tatomarinelli/esp-midi-phere/gui/docs/README.md

# Documentación

| Documento | De qué trata |
|---|---|
| `sysex.md` | Cómo hablan la GUI y el ESP: trama, comandos, ACK, config |
| `bootloader.md` | Entrar al modo descarga por software, flashear y volver |
| `remote-script.md` | Cómo funciona el Remote Script de Ableton y cómo instalarlo |

El estado general del proyecto, las decisiones y lo pendiente están en `../STATUS.md`.
