tatomarinelli/esp-midi-phere/enclosure/test-prints/test_holes.stl

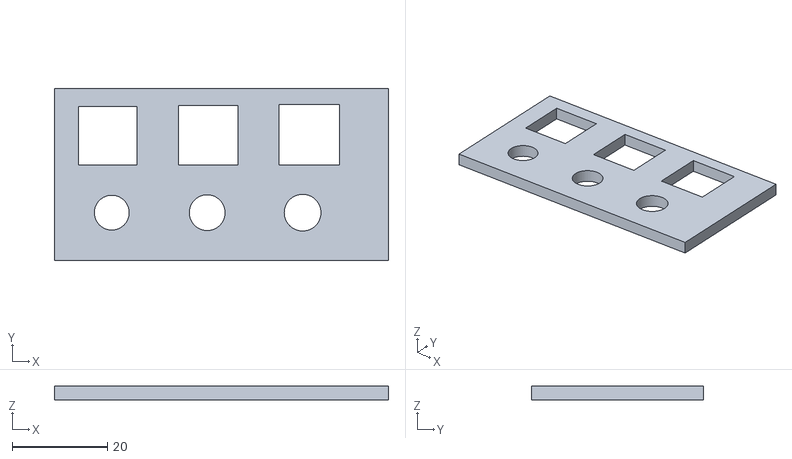
[picture p1: CAD file, 2026-10-25]
enclosure/test-prints/test_holes.stl
70.0 x 36.0 x 3.00
