tatomarinelli/esp-midi-phere/gui/assets/models/panel_print.stl

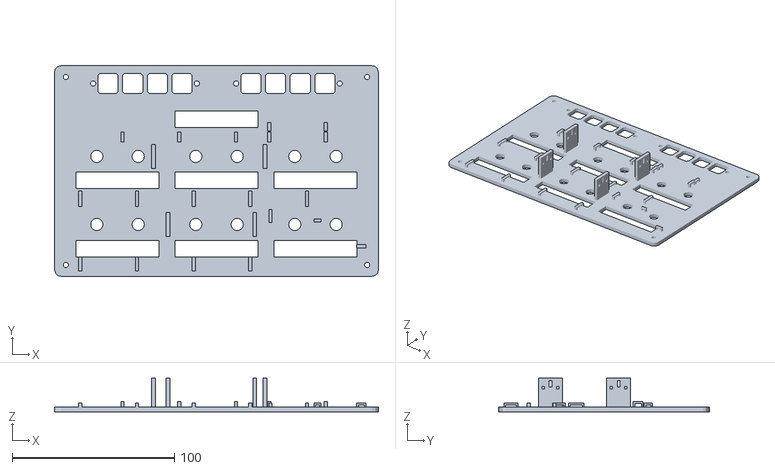
[picture p2: CAD file, 2026-10-25]
gui/assets/models/panel_print.stl
200.0 x 130.0 x 20.9
