tatomarinelli/esp-midi-phere/enclosure/test-prints/test_socket.stl

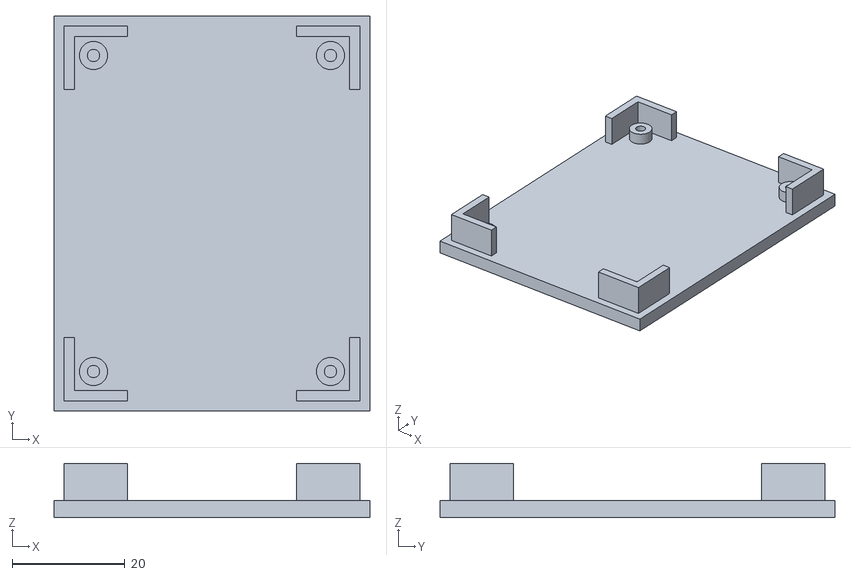
[picture p3: CAD file, 2026-10-25]
enclosure/test-prints/test_socket.stl
56.0 x 70.0 x 9.59
