tatomarinelli/esp-midi-phere/gui/assets/models/shell.stl

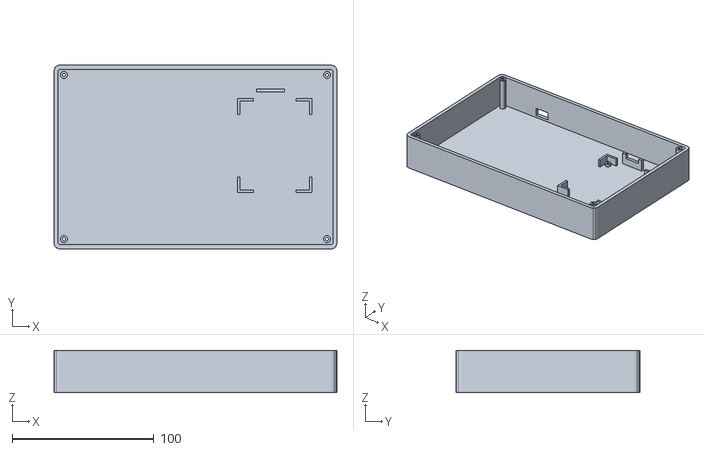
[picture p4: CAD file, 2026-10-25]
gui/assets/models/shell.stl
200.0 x 130.0 x 30.0
