tatomarinelli/esp-midi-phere/enclosure/test-prints/test_usbcut.stl

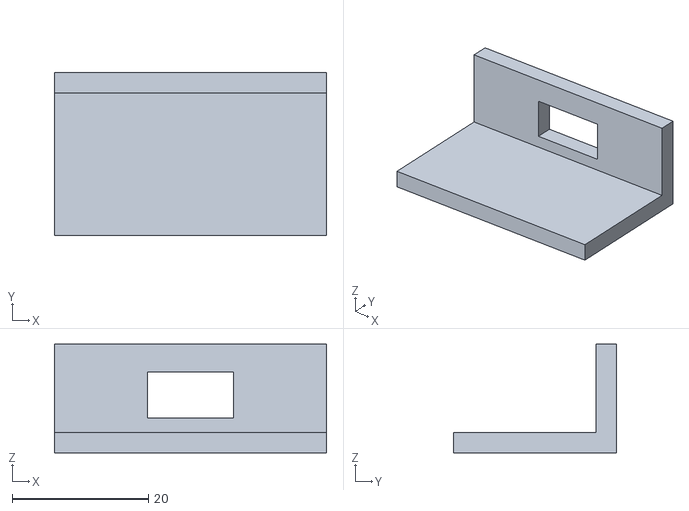
[picture p5: CAD file, 2026-10-25]
enclosure/test-prints/test_usbcut.stl
40.0 x 24.0 x 16.0
