tatomarinelli/esp-midi-phere/enclosure/test-prints/test_lid.stl

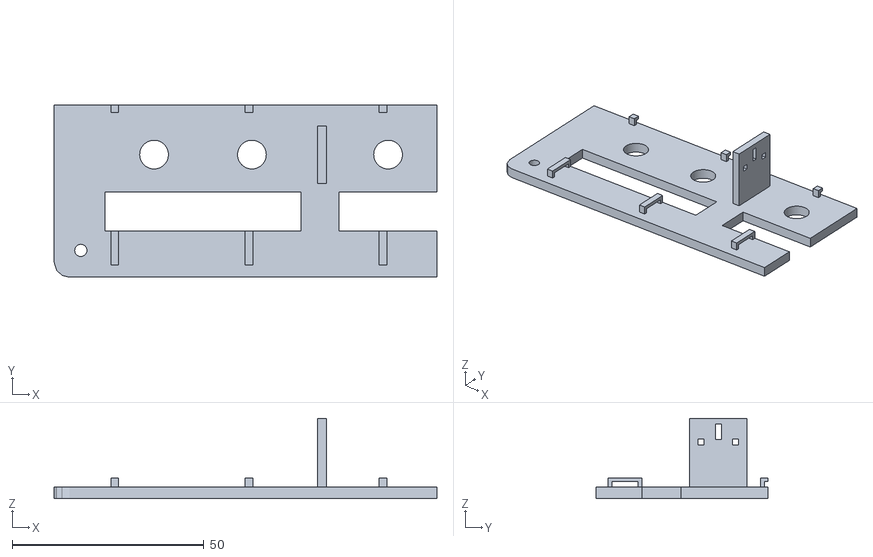
[picture p6: CAD file, 2026-10-25]
enclosure/test-prints/test_lid.stl
100.0 x 45.0 x 20.9
