tatomarinelli/esp-midi-phere/enclosure/esp-midi-phere-top-template-v7.pdf

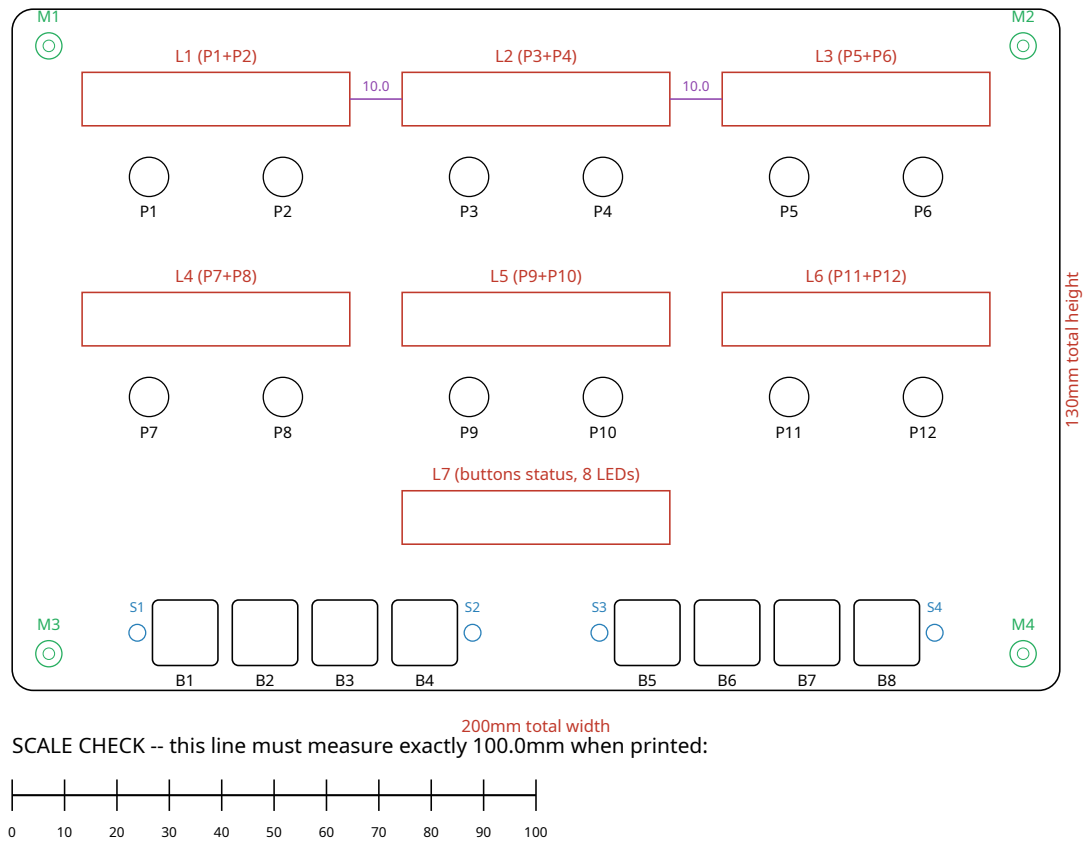
[picture p7: page 1]

SCALE CHECK -- this line must measure exactly 100.0mm when printed:
