tatomarinelli/esp-midi-phere/hardware/esp-midi-phere.kicad_sch

## KiCad design hardware/esp-midi-phere.kicad_sch (2026-10-23)

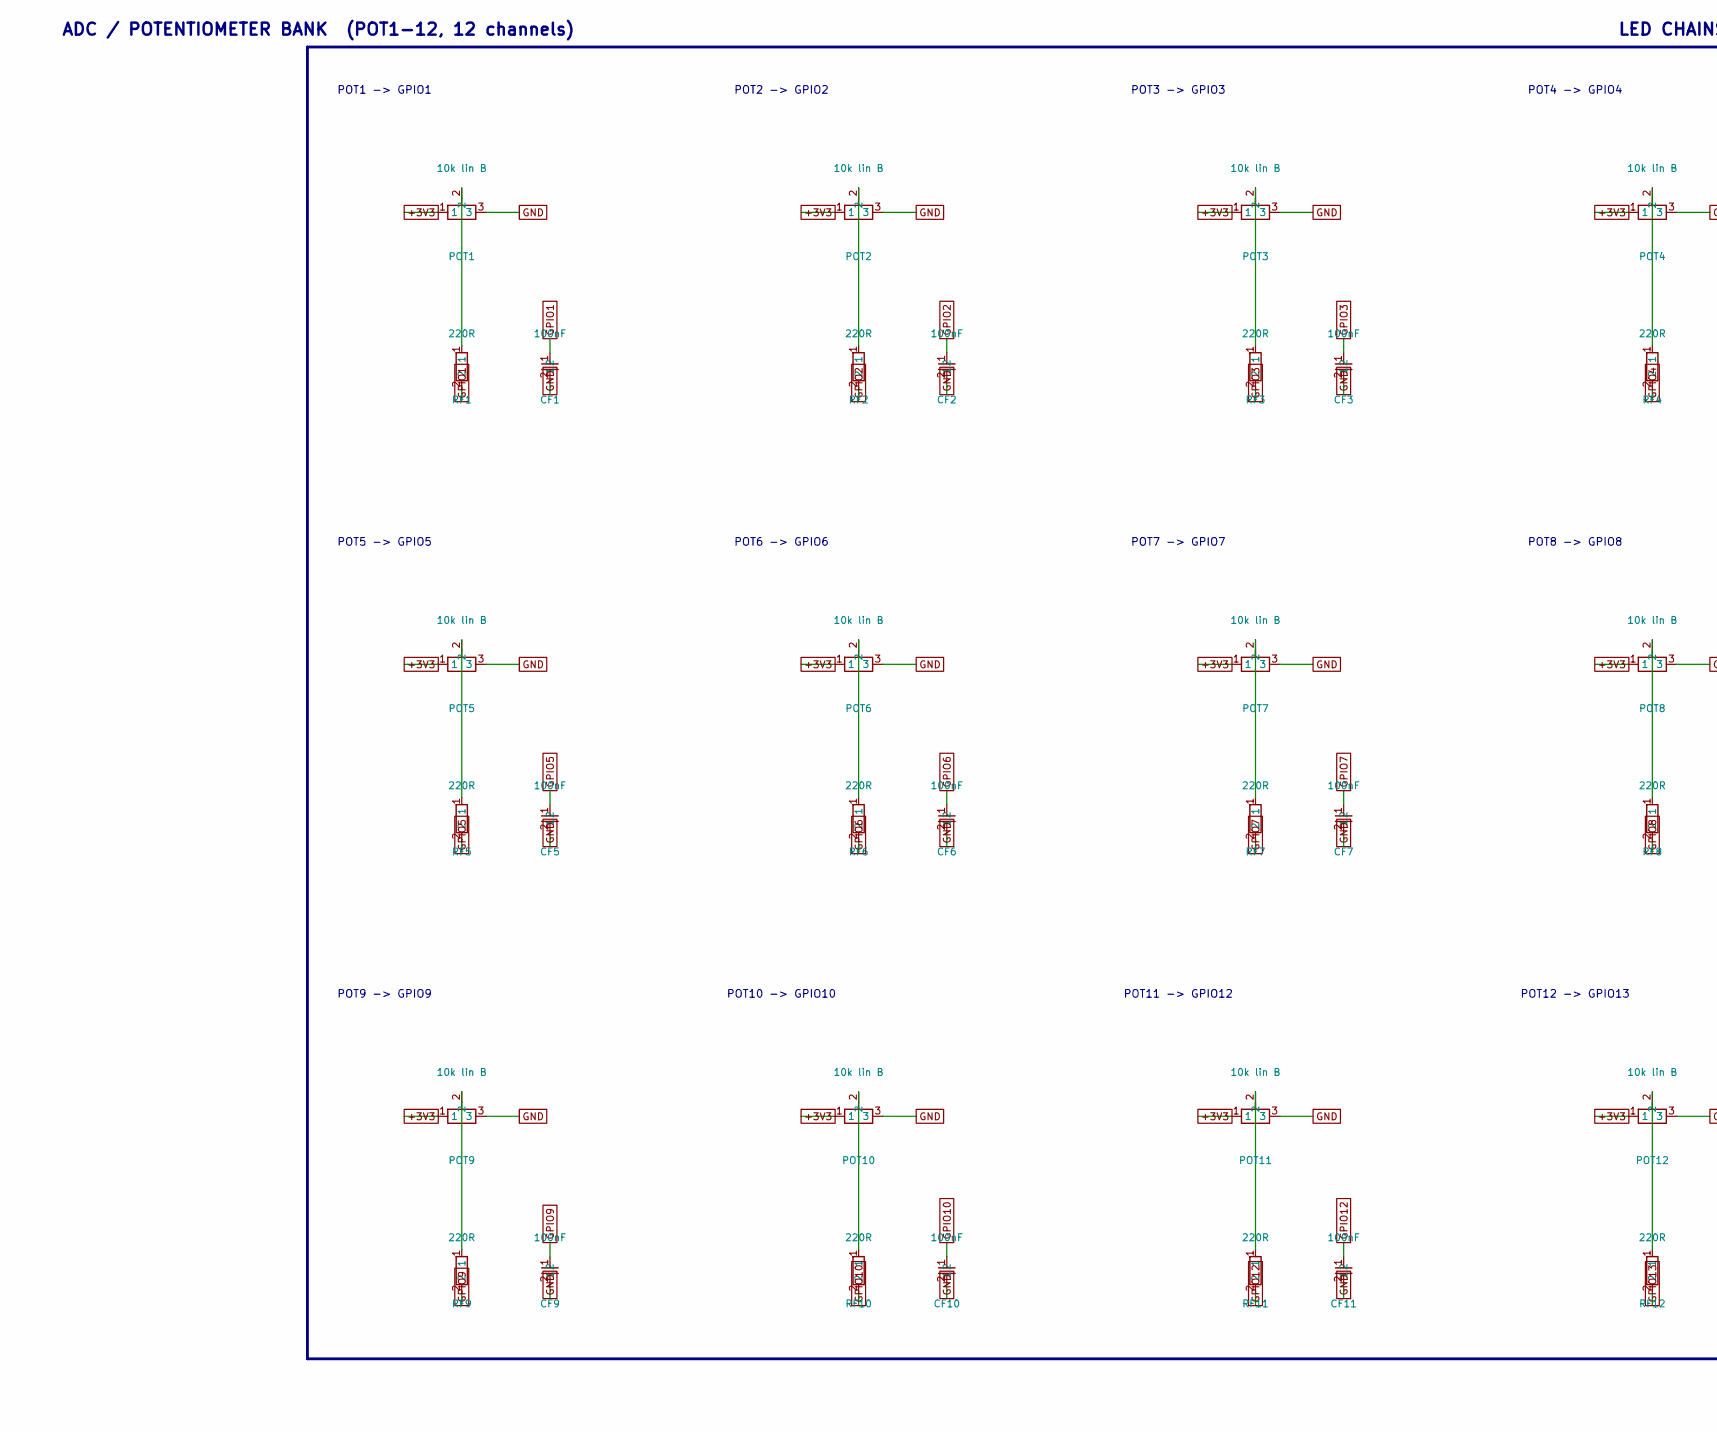
[picture p8: schematic esp-midi-phere.kicad_sch, part in row 1, column 1]

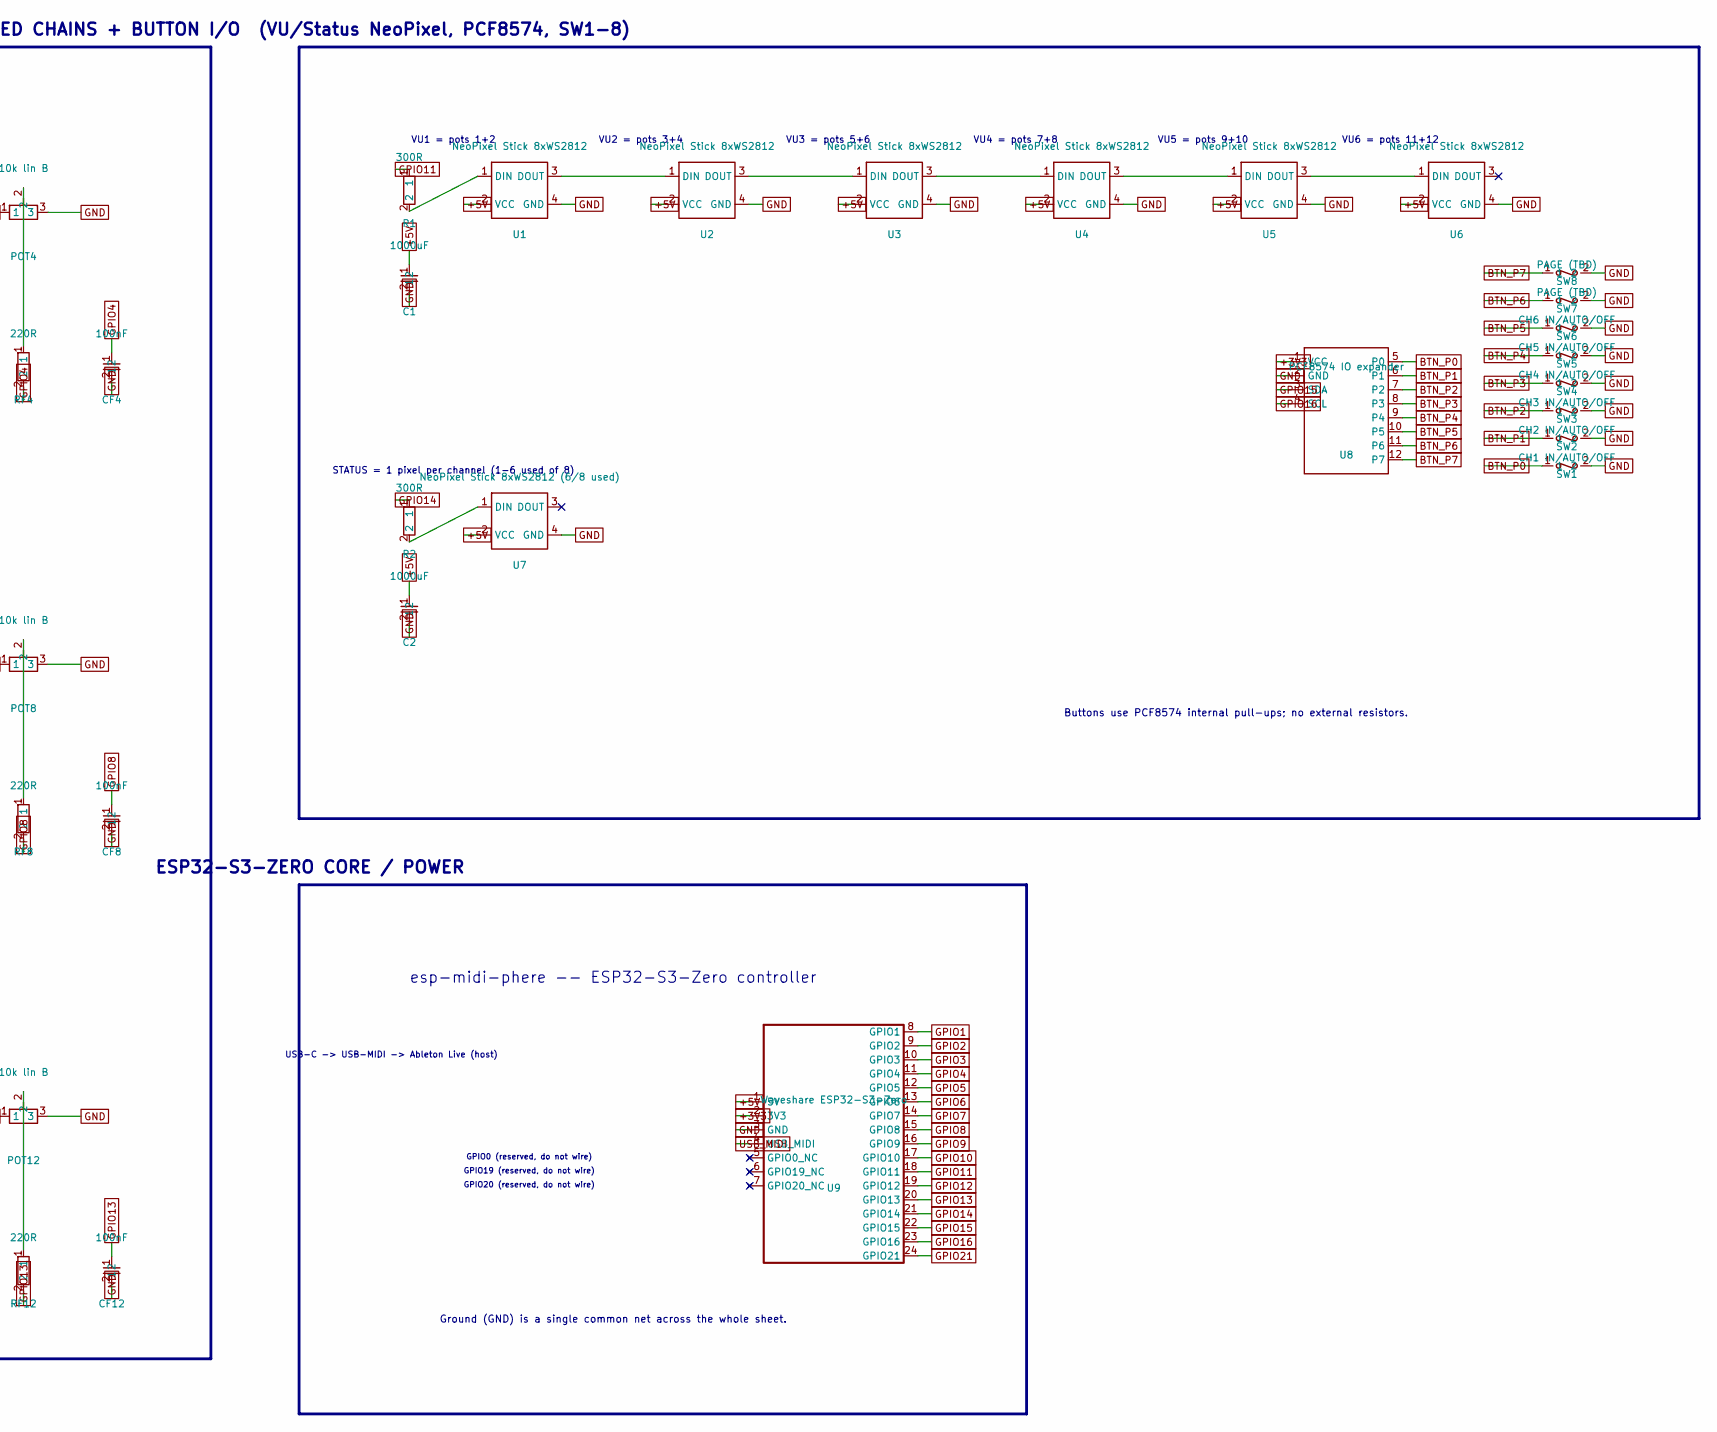
[picture p9: schematic esp-midi-phere.kicad_sch, part in row 1, column 2]

Parts:
C1, C2: 1000uF
CF1, CF2, CF3, CF4, CF5, CF6, CF7, CF8, CF9, CF10, CF11, CF12: 100nF
POT1, POT2, POT3, POT4, POT5, POT6, POT7, POT8, POT9, POT10, POT11, POT12: 10k lin B
R1, R2: 300R
RF1, RF2, RF3, RF4, RF5, RF6, RF7, RF8, RF9, RF10, RF11, RF12: 220R
SW1: CH1 IN/AUTO/OFF
SW2: CH2 IN/AUTO/OFF
SW3: CH3 IN/AUTO/OFF
SW4: CH4 IN/AUTO/OFF
SW5: CH5 IN/AUTO/OFF
SW6: CH6 IN/AUTO/OFF
SW7, SW8: PAGE (TBD)
U1, U2, U3, U4, U5, U6: NeoPixel Stick 8xWS2812
U7: NeoPixel Stick 8xWS2812 (6/8 used)
U8: PCF8574 IO expander
U9: Waveshare ESP32-S3-Zero

Connections:
+3V3: POT1.1, POT2.1, POT3.1, POT4.1, POT5.1, POT6.1, POT7.1, POT8.1, POT9.1, POT10.1, POT11.1, POT12.1, U8.1 (VCC), U9.2 (3V3)
+5V: C1.1, C2.1, U1.2 (VCC), U2.2 (VCC), U3.2 (VCC), U4.2 (VCC), U5.2 (VCC), U6.2 (VCC), U7.2 (VCC), U9.1 (5V)
BTN_P0: SW1.1, U8.5 (P0)
BTN_P1: SW2.1, U8.6 (P1)
BTN_P2: SW3.1, U8.7 (P2)
BTN_P3: SW4.1, U8.8 (P3)
BTN_P4: SW5.1, U8.9 (P4)
BTN_P5: SW6.1, U8.10 (P5)
BTN_P6: SW7.1, U8.11 (P6)
BTN_P7: SW8.1, U8.12 (P7)
GND: C1.2, C2.2, CF1.2, CF2.2, CF3.2, CF4.2, CF5.2, CF6.2, CF7.2, CF8.2, CF9.2, CF10.2, CF11.2, CF12.2, POT1.3, POT2.3, POT3.3, POT4.3, POT5.3, POT6.3, POT7.3, POT8.3, POT9.3, POT10.3, POT11.3, POT12.3, SW1.2, SW2.2, SW3.2, SW4.2, SW5.2, SW6.2, SW7.2, SW8.2, U1.4 (GND), U2.4 (GND), U3.4 (GND), U4.4 (GND), U5.4 (GND), U6.4 (GND), U7.4 (GND), U8.2 (GND), U9.3 (GND)
GPIO1: CF1.1, RF1.2, U9.8 (GPIO1)
GPIO2: CF2.1, RF2.2, U9.9 (GPIO2)
GPIO3: CF3.1, RF3.2, U9.10 (GPIO3)
GPIO4: CF4.1, RF4.2, U9.11 (GPIO4)
GPIO5: CF5.1, RF5.2, U9.12 (GPIO5)
GPIO6: CF6.1, RF6.2, U9.13 (GPIO6)
GPIO7: CF7.1, RF7.2, U9.14 (GPIO7)
GPIO8: CF8.1, RF8.2, U9.15 (GPIO8)
GPIO9: CF9.1, RF9.2, U9.16 (GPIO9)
GPIO10: CF10.1, RF10.2, U9.17 (GPIO10)
GPIO11: R1.1, U9.18 (GPIO11)
GPIO12: CF11.1, RF11.2, U9.19 (GPIO12)
GPIO13: CF12.1, RF12.2, U9.20 (GPIO13)
GPIO14: R2.1, U9.21 (GPIO14)
GPIO15: U8.3 (SDA), U9.22 (GPIO15)
GPIO16: U8.4 (SCL), U9.23 (GPIO16)
GPIO21: U9.24 (GPIO21)
unnamed: POT1.2, RF1.1
unnamed: POT2.2, RF2.1
unnamed: POT3.2, RF3.1
unnamed: POT4.2, RF4.1
unnamed: POT5.2, RF5.1
unnamed: POT6.2, RF6.1
unnamed: POT7.2, RF7.1
unnamed: POT8.2, RF8.1
unnamed: POT9.2, RF9.1
unnamed: POT10.2, RF10.1
unnamed: POT11.2, RF11.1
unnamed: POT12.2, RF12.1
unnamed: R1.2, U1.1 (DIN)
unnamed: R2.2, U7.1 (DIN)
unnamed: U1.3 (DOUT), U2.1 (DIN)
unnamed: U2.3 (DOUT), U3.1 (DIN)
unnamed: U3.3 (DOUT), U4.1 (DIN)
unnamed: U4.3 (DOUT), U5.1 (DIN)
unnamed: U5.3 (DOUT), U6.1 (DIN)
USB_MIDI: U9.4 (USB_MIDI)

Notes on the sheet:
POT1 -> GPIO1
POT2 -> GPIO2
POT3 -> GPIO3
POT4 -> GPIO4
POT5 -> GPIO5
POT6 -> GPIO6
POT7 -> GPIO7
POT8 -> GPIO8
POT9 -> GPIO9
POT10 -> GPIO10
POT11 -> GPIO12
POT12 -> GPIO13
VU1 = pots 1+2
VU2 = pots 3+4
VU3 = pots 5+6
VU4 = pots 7+8
VU5 = pots 9+10
VU6 = pots 11+12
STATUS = 1 pixel per channel (1-6 used of 8)
Buttons use PCF8574 internal pull-ups; no external resistors.
USB-C -> USB-MIDI -> Ableton Live (host)
GPIO0 (reserved, do not wire)
GPIO19 (reserved, do not wire)
GPIO20 (reserved, do not wire)
esp-midi-phere -- ESP32-S3-Zero controller
Ground (GND) is a single common net across the whole sheet.
ADC / POTENTIOMETER BANK (POT1-12, 12 channels)
LED CHAINS + BUTTON I/O (VU/Status NeoPixel, PCF8574, SW1-8)
ESP32-S3-ZERO CORE / POWER
