tatomarinelli/esp-midi-phere/(commit log)

2026-10-23 Snapshot before cleanup
    [esp-midi-phere-box-v5-assembled.stl, esp-midi-phere-box-v5-panel.stl, esp-midi-phere-box-v5-shell.stl, esp-midi-phere-top-template-v5.scad, esp-midi-phere-top-template-v7.scad, esp-midi-phere.kicad_sch, timeshare-enclosure.scad]
2026-10-23 Clean up: remove v5 enclosure, backups, old prototypes, analysis cache
    [esp-midi-phere-box-v5-assembled.stl, esp-midi-phere-box-v5-panel.stl, esp-midi-phere-box-v5-shell.stl, esp-midi-phere-top-template-v5.scad]
2026-10-23 Enclosure: lid arches and pot grips, USB-C extender mount, board socket, export script
    Panel: arches along the free corridors for the thin LED and button wires,
    hanging grips (one tall hole per pot row for the wipers, plus the 3V3/GND
    buses). Shell: protoboard socket, USB-C extender cutout, semi-closed nozzles
    for the USB cable. export-stl.sh regenerates the STL files for the GUI.
    [esp-midi-phere-top-template-v7.scad]
2026-10-25 Enclosure: test prints, export script and README updates
    [esp-midi-phere-top-template-v7.scad, test_holes.stl, test_lid.stl, test_socket.stl, test_usbcut.stl]
2026-10-25 Add GUI controller (web config tool, docs, 3D wiring view)
    [panel_print.stl, shell.stl]
